suryagandikota444/qdd-actuator/full_view_no_backplate.png

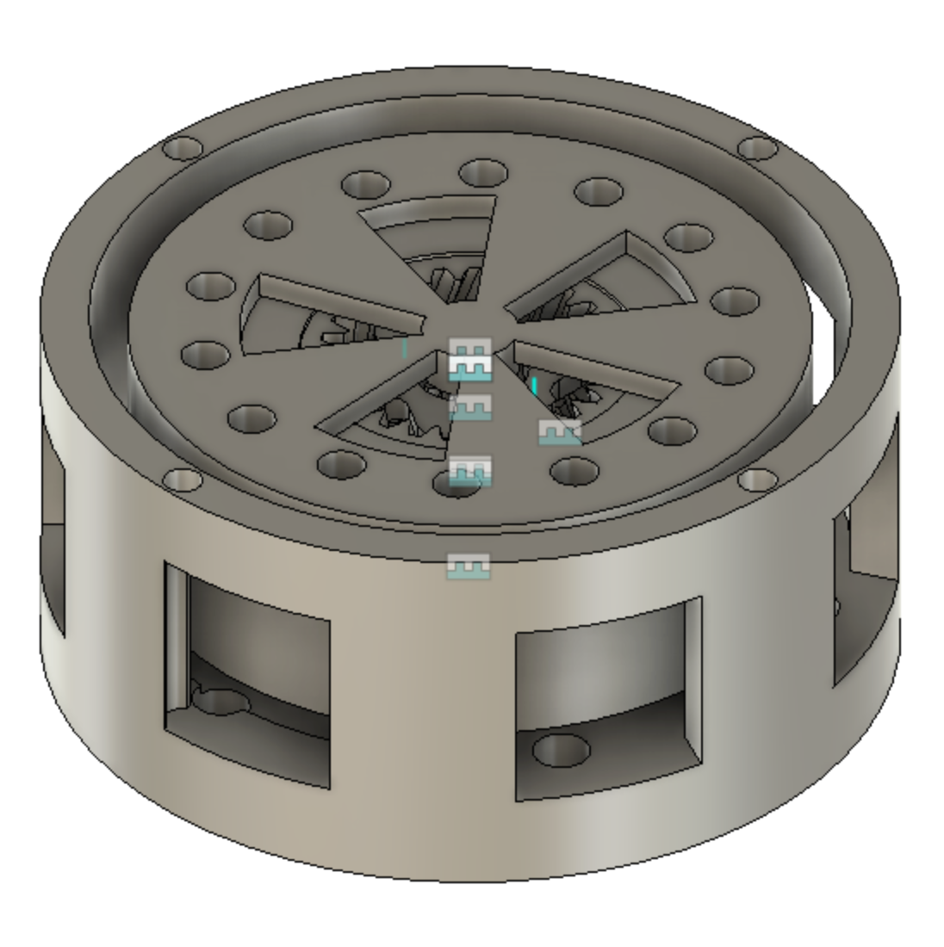
full_view_no_backplate.png
