suryagandikota444/qdd-actuator/full_view_no_output.png

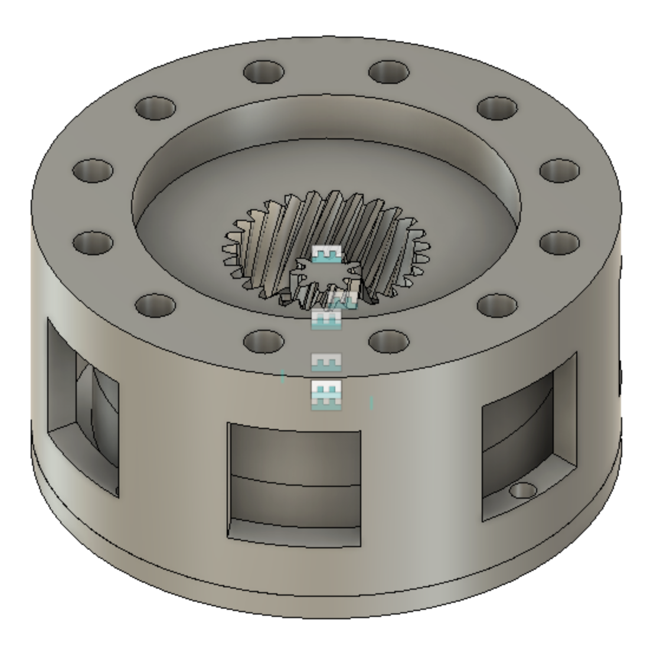
full_view_no_output.png
