suryagandikota444/qdd-actuator/design files/Backplate.stl

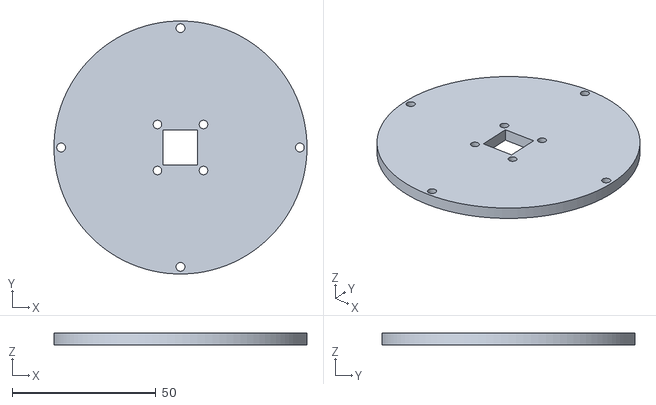
[picture p8: CAD file, 2025-11-07]
design files/Backplate.stl
88.0 x 88.0 x 4.00
