suryagandikota444/qdd-actuator/design files/gearbox/First Stage Output Sun Gear.stl

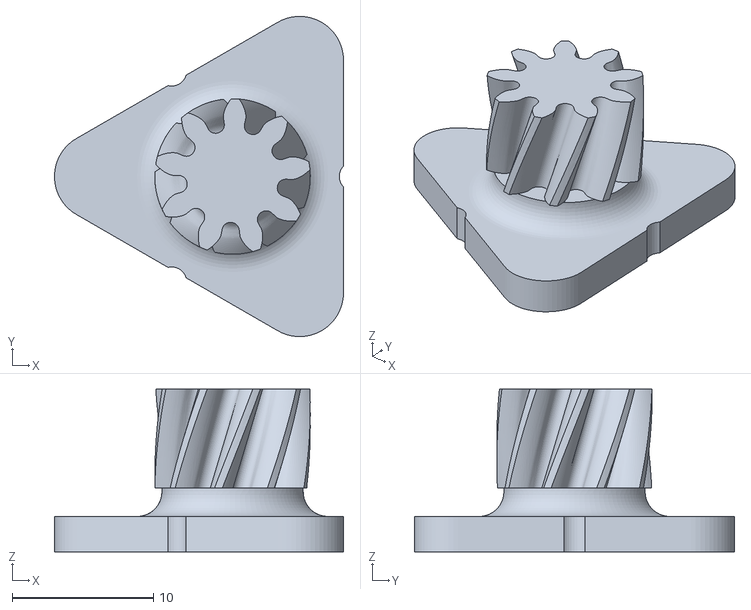
[picture p9: CAD file, 2025-11-07]
design files/gearbox/First Stage Output Sun Gear.stl
20.4 x 22.7 x 11.5
