suryagandikota444/qdd-actuator/design files/gearbox/Second Stage Output.stl

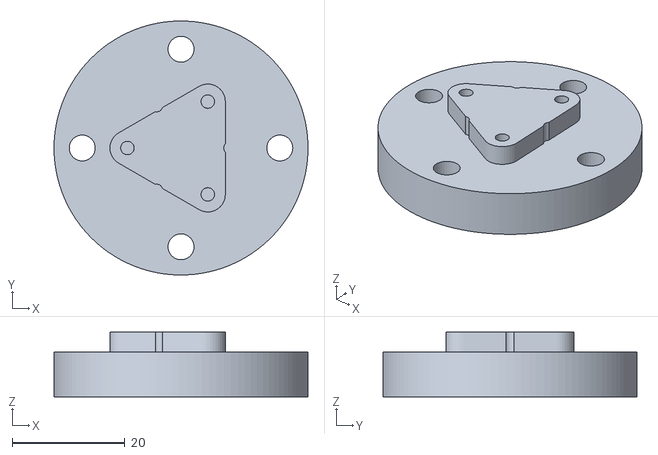
[picture p10: CAD file, 2025-11-07]
design files/gearbox/Second Stage Output.stl
45.0 x 45.0 x 11.5
