suryagandikota444/qdd-actuator/design files/Rotor.stl

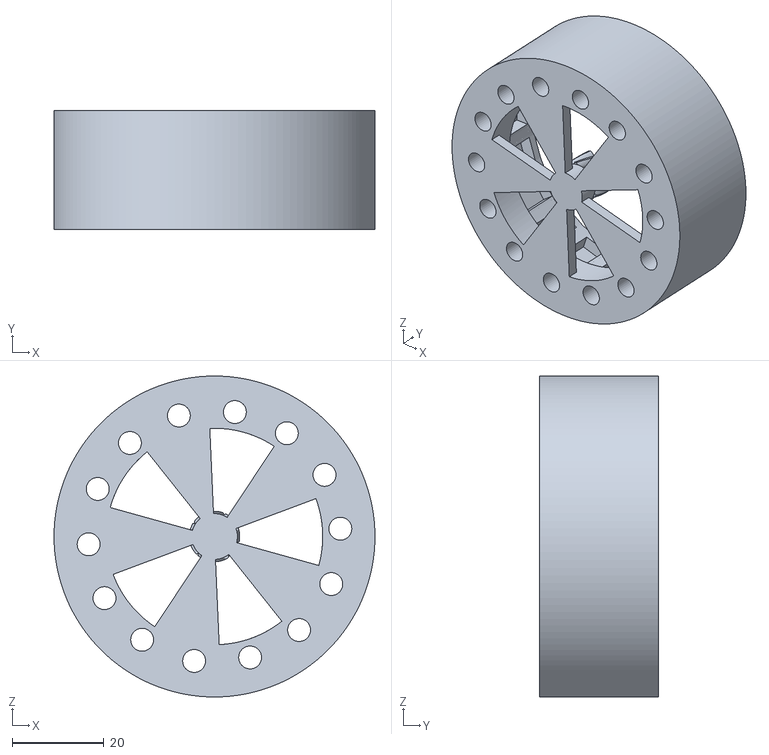
[picture p11: CAD file, 2025-11-07]
design files/Rotor.stl
70.0 x 26.0 x 70.0
