suryagandikota444/qdd-actuator/design files/Frame.stl

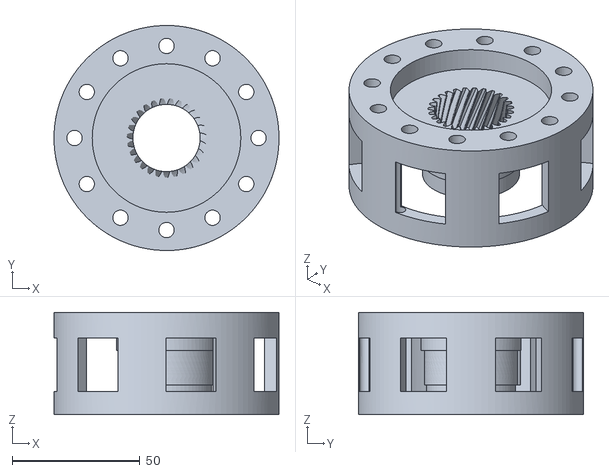
[picture p12: CAD file, 2025-11-07]
design files/Frame.stl
88.0 x 88.0 x 40.0
