suryagandikota444/qdd-actuator/design files/gearbox/Planet Gear.stl

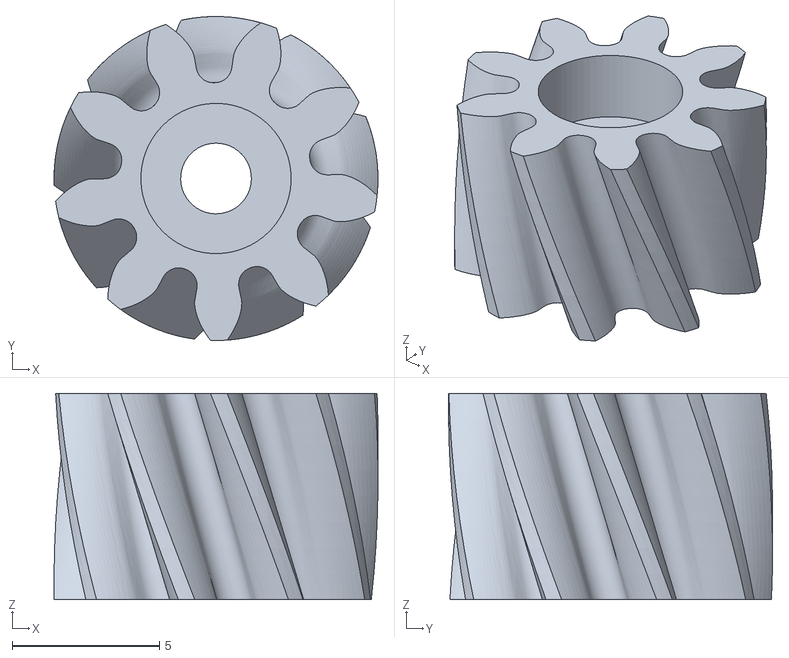
[picture p13: CAD file, 2025-11-07]
design files/gearbox/Planet Gear.stl
11.0 x 11.0 x 7.00
