suryagandikota444/qdd-actuator/design files/gearbox/Carrier.stl

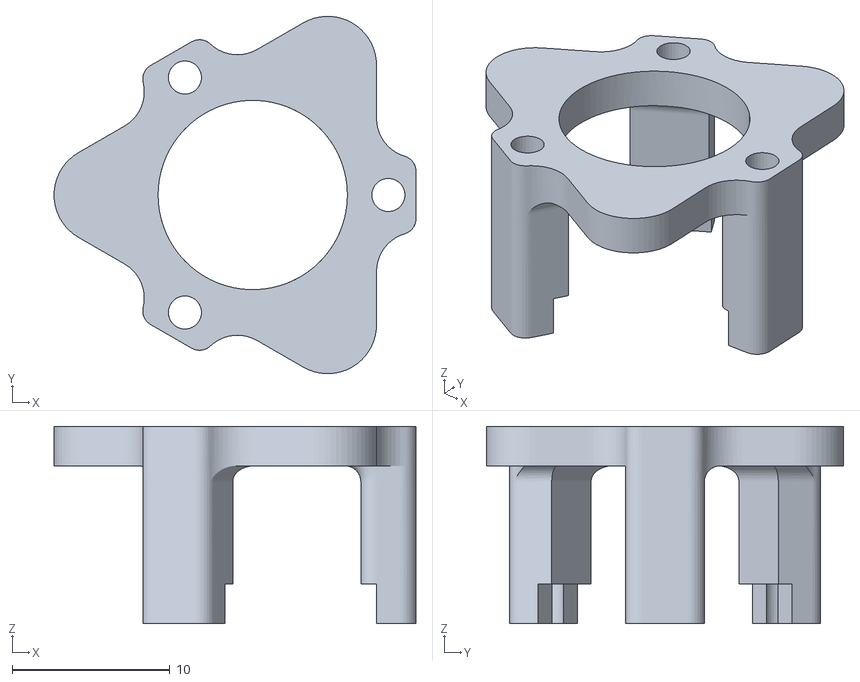
[picture p14: CAD file, 2025-11-07]
design files/gearbox/Carrier.stl
22.9 x 22.6 x 12.5
