suryagandikota444/qdd-actuator/(commit log)

2025-11-07 Added design files
    [Backplate.stl, Carrier.stl, First Stage Output Sun Gear.stl, Frame.stl, Planet Gear.stl, Rotor.stl, Second Stage Output.stl]
2025-11-07 Replace gear image with gearbox image in README
    Updated image references in README for clarity.
